nguyentrungg/Project_1/(list of files, drawings)

Other design files:
PCB/Project_1/ESP_PCB.PcbDoc
PCB/Project_1/ESP_SCH.SchDoc
PCB/Project_1/Project_1_PCB.PrjPcb
